SumantBagri/Autonomous-Navigation-and-Obstacle-Avoidance-Robot/Document Image Editing.png

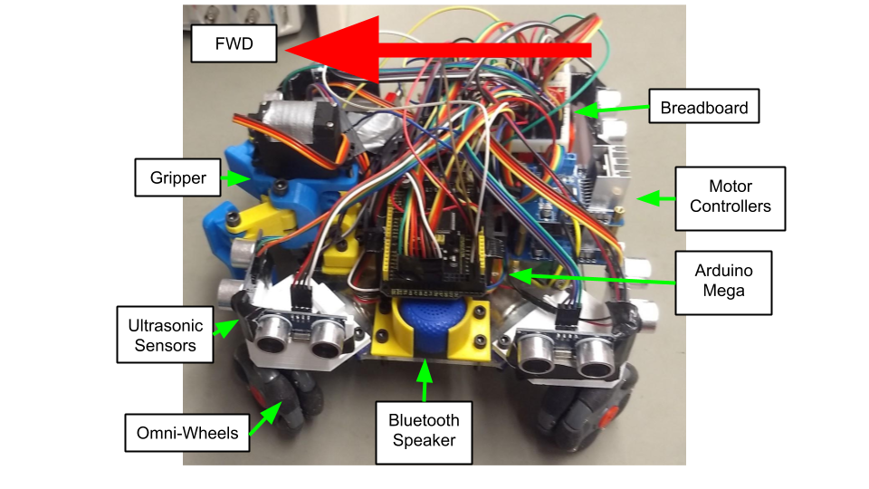
Document Image Editing.png
