SumantBagri/Autonomous-Navigation-and-Obstacle-Avoidance-Robot/Bottom View - CAD.JPG

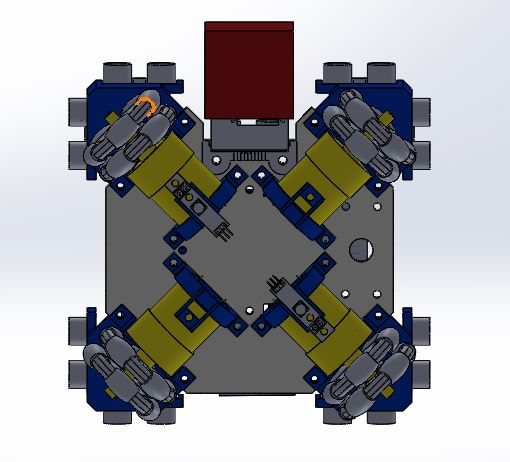
Bottom View - CAD.JPG
