SumantBagri/Autonomous-Navigation-and-Obstacle-Avoidance-Robot/CAD/CADModel.pptx

Ultrasonic Sensor (pair)

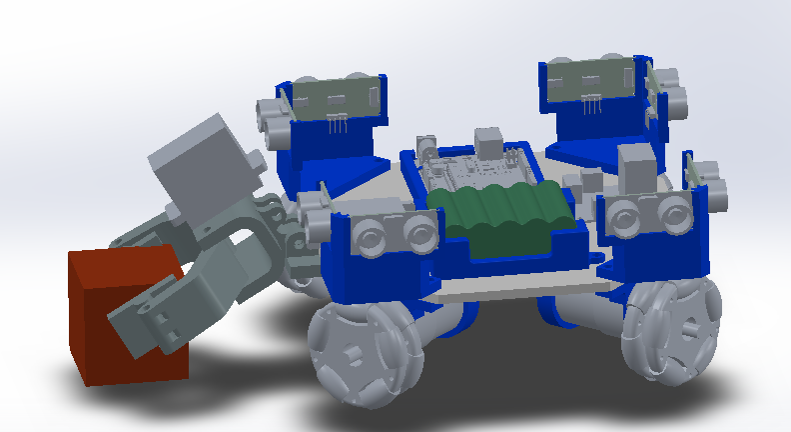
[picture p3: figure]

Arduino Uno

Servo Motor

2”x2”x2” Target Block

Omni-directional Wheel

IR Sensor (not visible)

12V Battery

12V DC Motor
