SumantBagri/Autonomous-Navigation-and-Obstacle-Avoidance-Robot/IMG_20181108_143803060_HDR.jpg

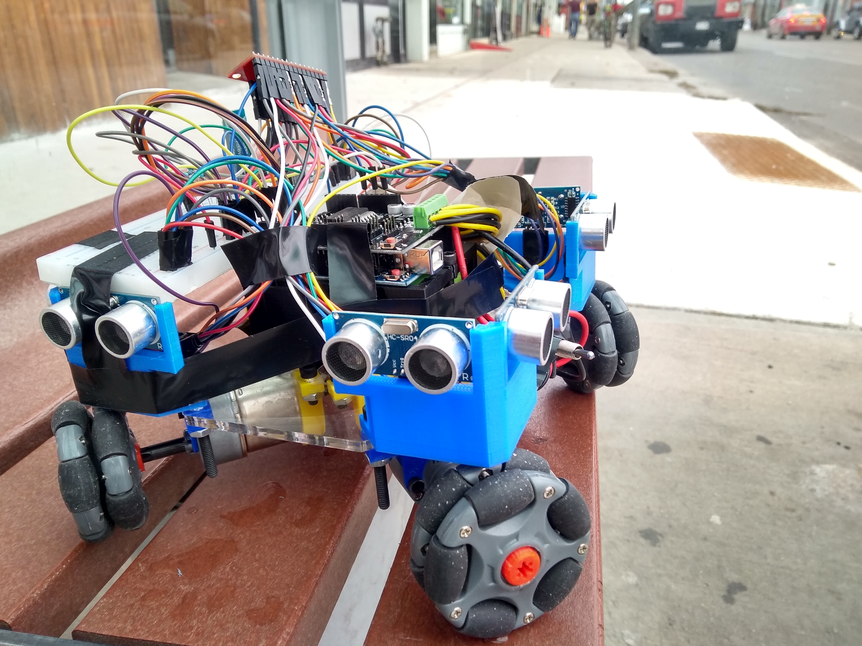
IMG_20181108_143803060_HDR.jpg
