SumantBagri/Autonomous-Navigation-and-Obstacle-Avoidance-Robot/CAD/Gripper Assembly.stp

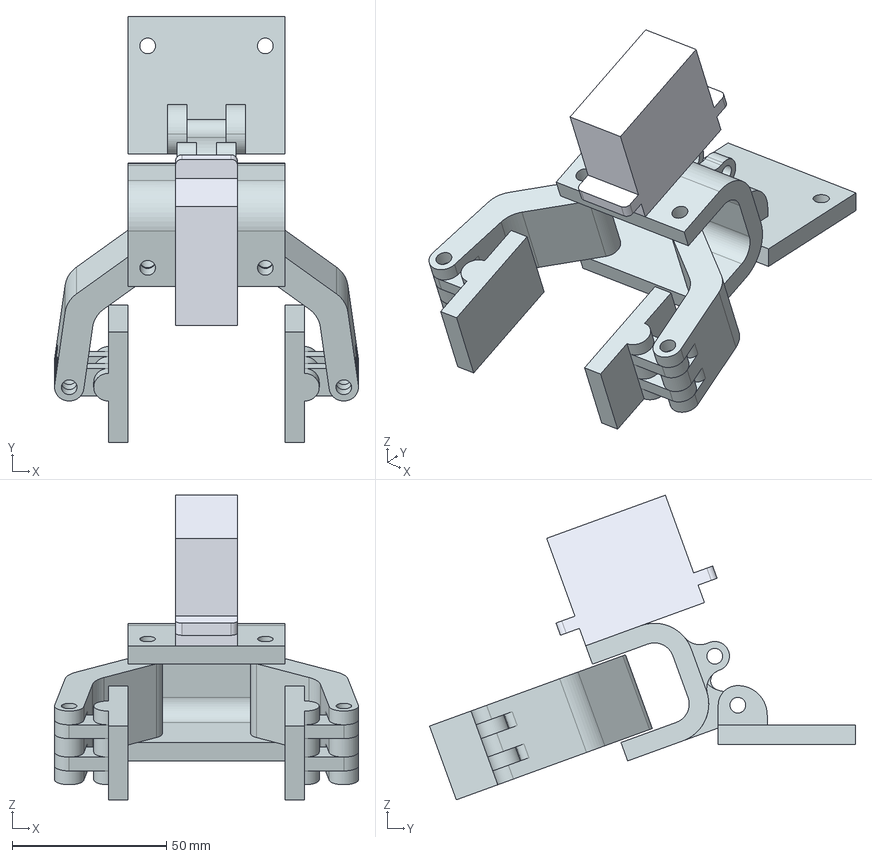
[picture p22: CAD file, 2019-08-07]
CAD/Gripper Assembly.stp
98.4 x 137.9 x 98.6 mm
Gripper Mount
Gripper piece 1 x 2
Gripper Part 2 x 2
444 - Servo Motor
Gripper robot mount
