SumantBagri/Autonomous-Navigation-and-Obstacle-Avoidance-Robot/CAD/Block Search/SensorServoMount.SLDPRT

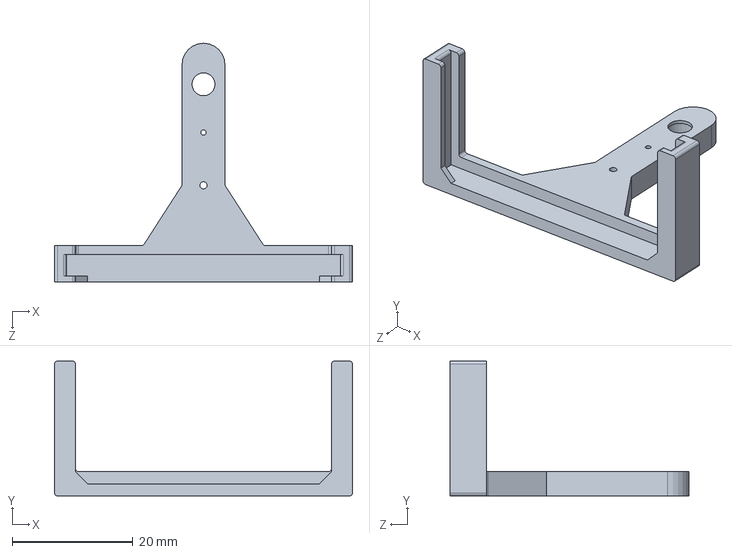
[picture p23: CAD file, 2019-08-07]
CAD/Block Search/SensorServoMount.SLDPRT
49.4 x 22.3 x 39.6 mm
