SumantBagri/Autonomous-Navigation-and-Obstacle-Avoidance-Robot/CAD/To Be Printed/444 - Motor Mount Rear.SLDPRT

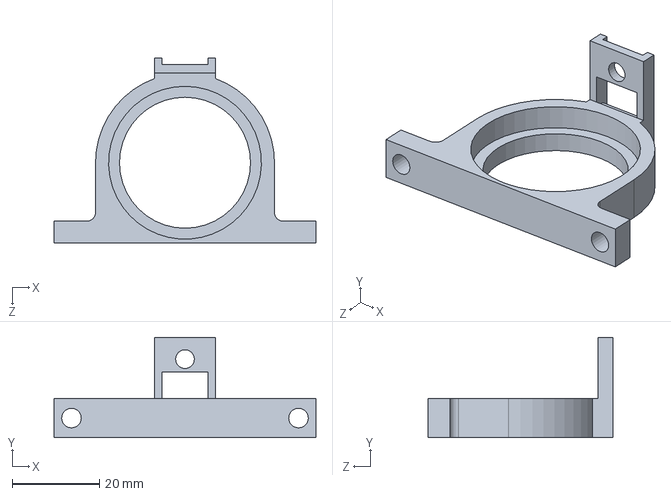
[picture p24: CAD file, 2019-08-07]
CAD/To Be Printed/444 - Motor Mount Rear.SLDPRT
60.0 x 23.0 x 42.4 mm
