SumantBagri/Autonomous-Navigation-and-Obstacle-Avoidance-Robot/CAD/Block Search/ServoRobotMount.SLDPRT

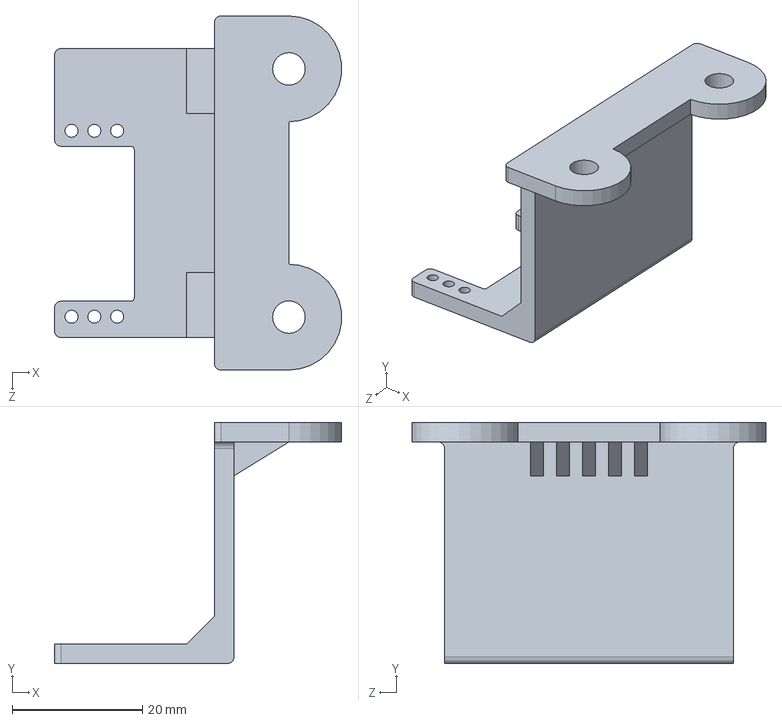
[picture p25: CAD file, 2019-08-07]
CAD/Block Search/ServoRobotMount.SLDPRT
44.1 x 37.0 x 54.3 mm
