SumantBagri/Autonomous-Navigation-and-Obstacle-Avoidance-Robot/CAD/To Be Printed/444 - Blinders.SLDPRT

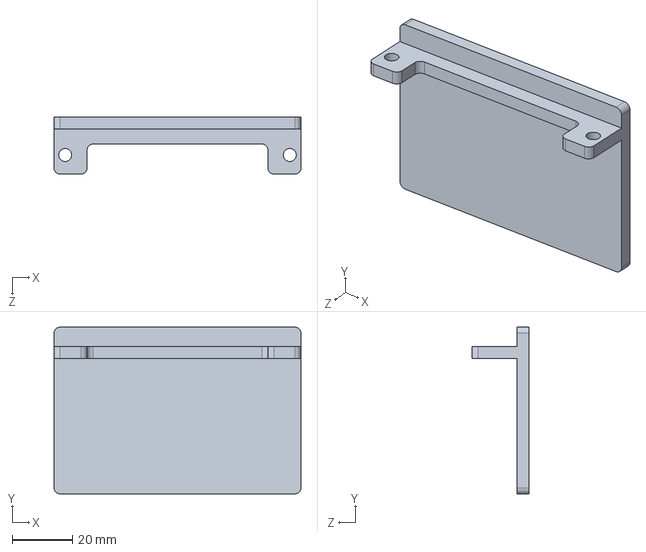
[picture p26: CAD file, 2019-08-07]
CAD/To Be Printed/444 - Blinders.SLDPRT
82.0 x 55.3 x 19.0 mm
