SumantBagri/Autonomous-Navigation-and-Obstacle-Avoidance-Robot/(list of files, cad)

Other CAD files:
CAD/Block Search/SensorServoMount.STL
CAD/Block Search/ServoRobotMount.STL
CAD/To Be Printed/444 - Blinders.STL
CAD/To Be Printed/444 - Motor Mount Rear.STL
