SumantBagri/Autonomous-Navigation-and-Obstacle-Avoidance-Robot/(commit log)

2019-08-07 Uploading all files
    [444 - Blinders.SLDPRT, 444 - Blinders.STL, 444 - Motor Mount Rear.SLDPRT, 444 - Motor Mount Rear.STL, Gripper Assembly.stp, SensorServoMount.SLDPRT, SensorServoMount.STL, ServoRobotMount.SLDPRT]
2019-08-07 Arduino Library
